GuillaumeCampagne/projet_Gouyer-Campagne/(list of files, cad)

Other CAD files:
rapport_seance_guillaume/Campagne-guillaume rapport séance 2/aile1.ipt
